samartzidis/NanoBot/models/head-bottom.stl

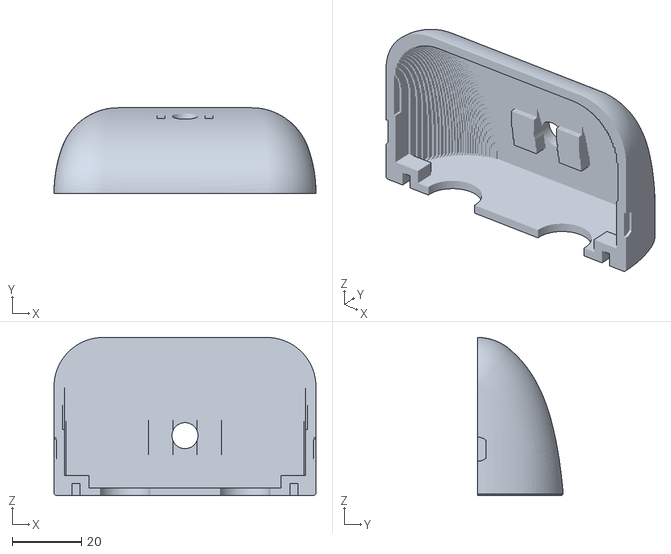
[picture p10: CAD file, 2026-02-01]
models/head-bottom.stl
75.6 x 24.7 x 45.6
