samartzidis/NanoBot/models/face.stl

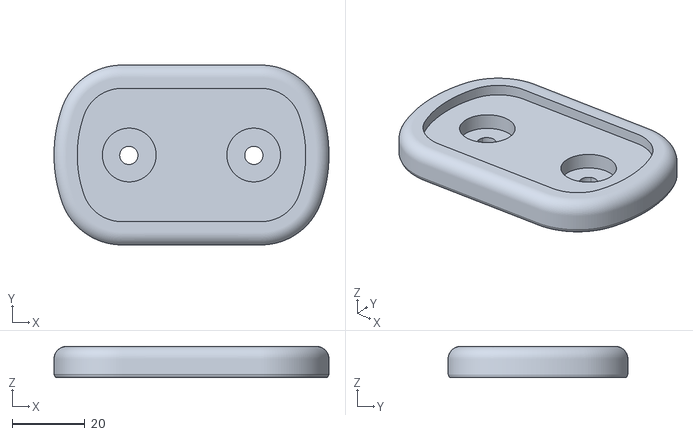
[picture p11: CAD file, 2026-02-01]
models/face.stl
75.6 x 49.4 x 8.61
