samartzidis/NanoBot/models/head-top.stl

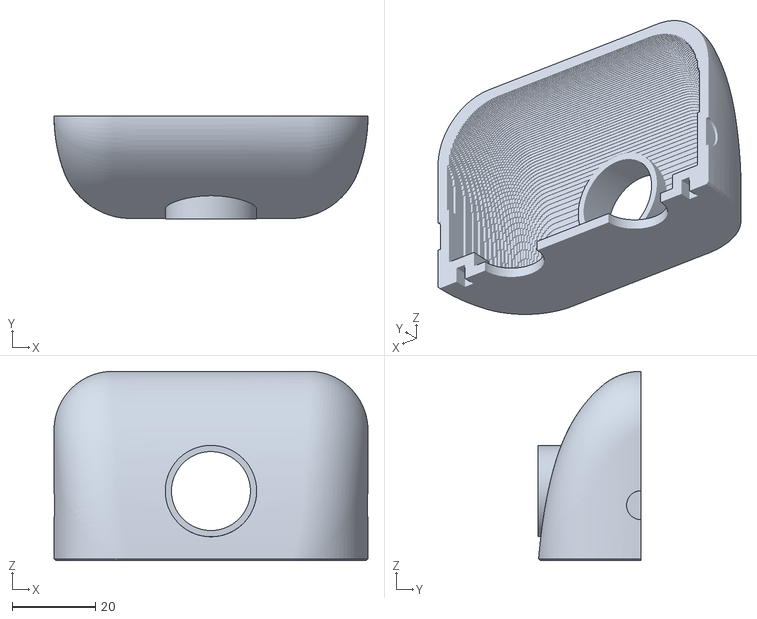
[picture p12: CAD file, 2026-02-01]
models/head-top.stl
75.6 x 24.8 x 45.6
