samartzidis/NanoBot/models/body.stl

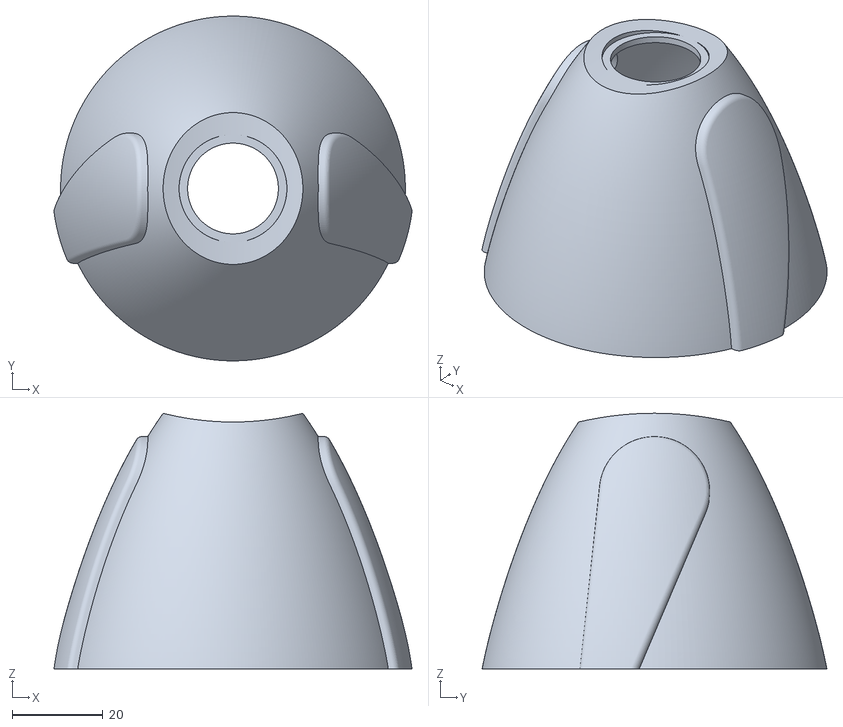
[picture p13: CAD file, 2026-02-01]
models/body.stl
79.0 x 76.0 x 56.4
