samartzidis/NanoBot/models/eyes.stl

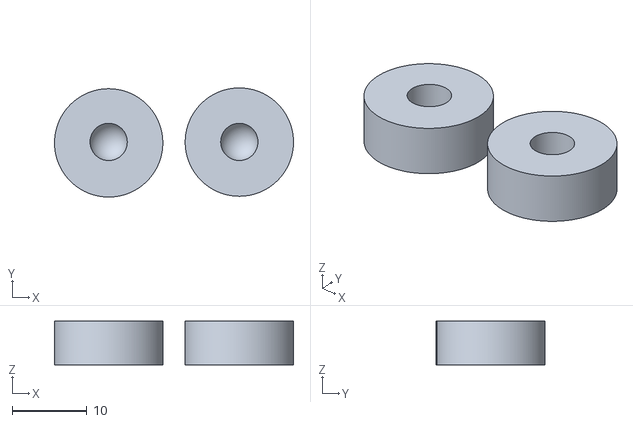
[picture p14: CAD file, 2026-02-01]
models/eyes.stl
32.1 x 14.6 x 5.88
