samartzidis/NanoBot/models/ears.stl

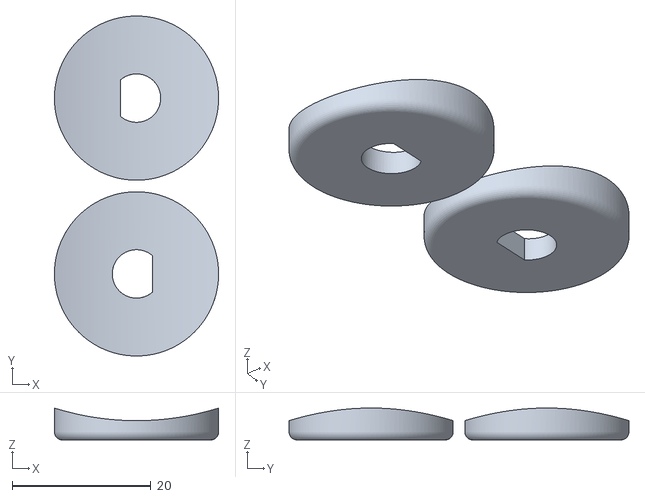
[picture p16: CAD file, 2026-02-01]
models/ears.stl
23.7 x 49.0 x 4.61
