samartzidis/NanoBot/models/antennas.stl

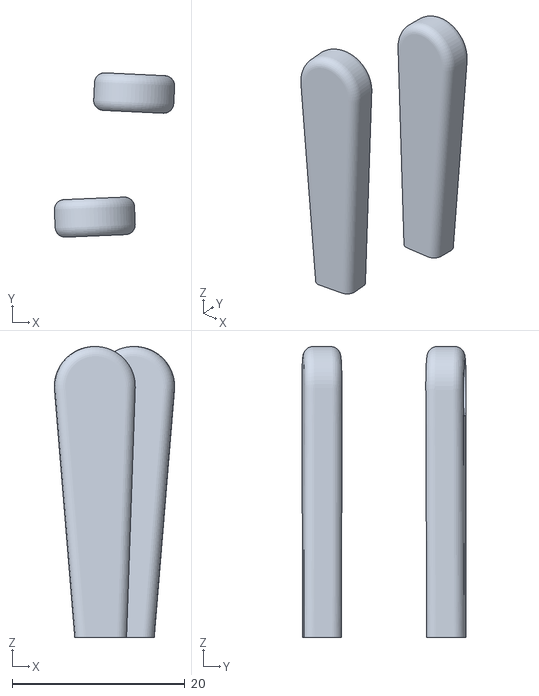
[picture p17: CAD file, 2026-02-01]
models/antennas.stl
13.9 x 19.1 x 33.7
