samartzidis/NanoBot/models/base.stl

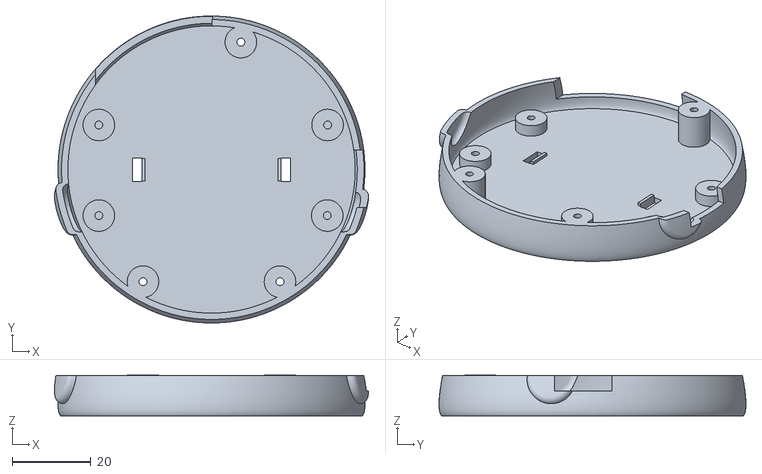
[picture p18: CAD file, 2026-02-01]
models/base.stl
79.7 x 77.9 x 10.3
