samartzidis/NanoBot/models/neck.stl

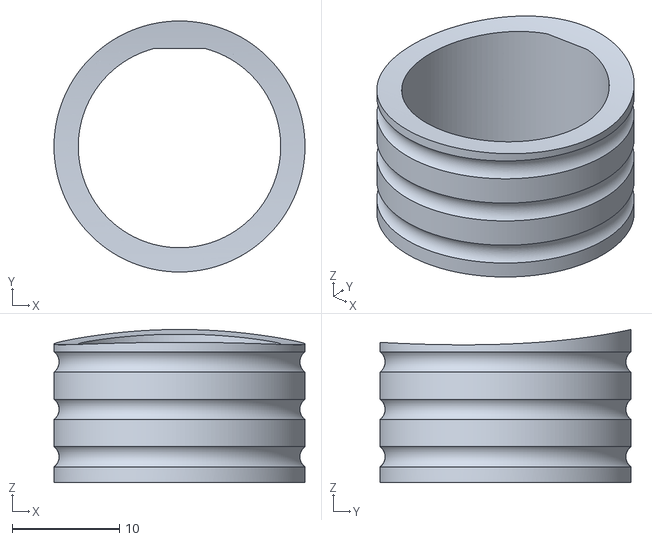
[picture p19: CAD file, 2026-02-01]
models/neck.stl
23.4 x 23.4 x 14.3
