samartzidis/NanoBot/models/S330-attachment-draft.3mf

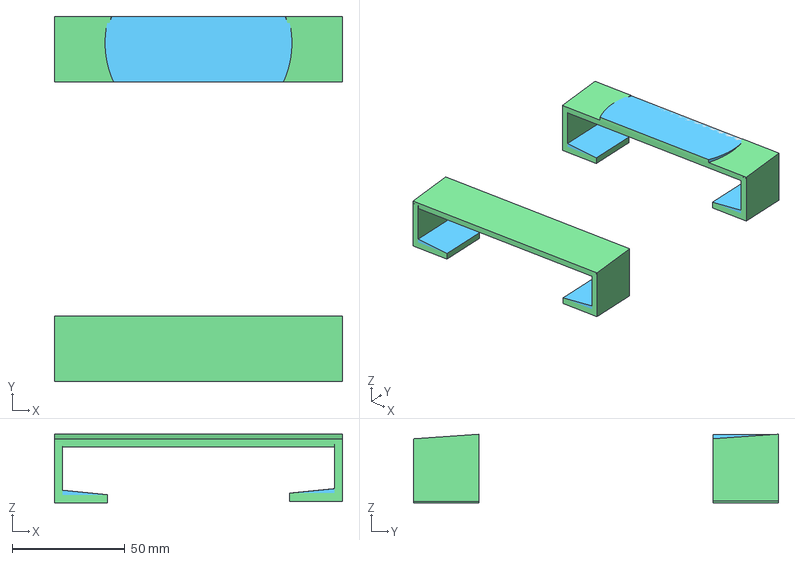
[picture p20: CAD file, 2025-01-10]
models/S330-attachment-draft.3mf
128.0 x 162.1 x 30.5 mm
