samartzidis/NanoBot/(commit log)

2025-11-06 Assign GPIO19 pin to optional speaker amplifier control
2025-11-10 Commented out Anker PowerConf S330 Driver code
2025-11-16 Extra led colours for noise,voice detection indication using PWM pins
2026-01-03 Restored PowerConfDeviceService
2026-02-01 Added printable STL files
    [antennas.stl, base.stl, body.stl, ear-bits.stl, ears.stl, eyes.stl, face.stl, head-bottom.stl]
2026-02-01 model updates
    [face.stl, head-bottom.stl, head-top.stl]
2026-02-01 models update
    [S330-attachment-draft.3mf, s330-speakerphone-attachment.stl]
2026-04-11 forwarding of tools to the powerai plugin
2026-04-12 PowerAIPlugin selection instructions moved to config
2026-04-25 Added filtering to logs UI page, improved error handling in RealtimeAgent
2026-05-09 Fix WebSocket disconnect logging and cancellation propagation
    When the OpenAI Realtime API closes the connection abruptly (no close
    handshake), the receive task now catches WebSocketException immediately,
    logs at Warning, and calls FaultSession() before rethrowing. Previously
    the exception silently faulted the task without calling FaultSession(),
    leaving the audio loop running until it hit the aborted socket itself and
    produced a misleading [Error] stack trace as a secondary symptom.
    Knock-on effects:
    - FaultSession() cancels _sessionCts promptly, so the audio loop receives
    OperationCanceledException via loopCts instead of WebSocketException
    - SystemService now has a dedicated catch (WebS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
2026-09-12 Simplify PowerAIPlugin to a single-shot completion
    The realtime agent already has direct access to the same tools and is
    instructed per-plugin to gather facts itself before escalating, making
    PowerAIPlugin's own tool-calling loop redundant. Removes the tools
    dependency, iteration loop, and InvokeToolAsync/BuildOptions tool wiring.
2026-09-12 Updated powerai prompt
2026-09-12 Introduce shared AudioOutputEngine for audio playback
    Speaker previously opened its own private MiniAudioEngine/AudioPlaybackDevice
    per instance, so two Speakers could contend for exclusive access to the same
    physical output. AudioOutputEngine (Services/) now owns the single output
    device as a DI singleton; Speaker requires it and only manages its own
    SoundPlayer/QueueDataProvider/level-meter on the engine's shared mixer, so
    multiple Speakers can mix in hardware instead. RealtimeAgent/RealtimeAgentFactory
    wire it through via constructor injection.
2026-10-03 Add Firecrawl-backed WebSearchPlugin
    Add an opt-in web search plugin using the Firecrawl v2 API.
    - SearchAsync: returns title/url/description only (cheap, no page
    content), with optional past-day and site filters
    - ReadPageAsync: answers a specific question from a page via the
    "question" format, falling back to truncated main-content markdown
    - Failures, empty results and empty pages return an explicit
    instruction telling the model not to guess
    - Add WebSearchPluginEnabled (per agent) and FirecrawlApiKey (app)
    config, UI schema entries and factory registration
    - Plugin instructions require user permission before searching and
    forbid presenting guesses or memory as web results
2026-10-11 Add picture upload into the realtime conversation
    Let users send a photo from the web UI (including the phone camera) so
    they can ask the robot about it by voice.
    - Add POST api/Conversation/Image (jpeg/png/webp/gif, 4 MB cap)
    - RealtimeAgent.AddImageAsync adds the image as a user input_image item
    without triggering a response; images are queued (max 3) when there is
    no live session and flushed after the session is configured
    - SystemService forwards images to the current agent, holds them until an
    agent exists, and says "Picture received" via local TTS
    - Set image_url through the part's JsonPatch because System.Uri rejects
    strings over ~65K chars on .NET 8, shorter than a base64 ph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
2026-10-11 Wake the agent into listening mode after an image upload
    When the system is idle waiting for a wake word, an uploaded image now
    wakes the agent the same way the hangup button does, so the user can ask
    about the picture straight away. The wake happens after the "Picture
    received" announcement so the microphone doesn't capture it. A live
    conversation is left untouched; the image goes straight into the session.
2026-10-12 Upload ui button move
2026-10-16 Let PowerAI see uploaded images via a labelled in-memory store
    Uploaded images are now kept in an in-memory IUploadedImageStore (max 5,
    drop oldest) and given short labels (img-1, img-2, ...). The realtime
    model is told each label via a text part sent with the image, and
    PowerAIPlugin.AskAsync gains an optional imageIds parameter that
    attaches the referenced images to the PowerAI request.
    - Add UploadedImageStore; the label counter never resets so a stale
    label can't alias a newer image
    - PendingImageQueue now carries StoredImage records (label + bytes + mime)
    - SystemService stores each upload first and clears the store on agent
    disposal, keeping images still queued for the next sessio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
2026-10-17 Remove GeoIP and Weather plugins
    Delete GeoIpPlugin and WeatherPlugin along with their AgentConfig
    flags, RealtimeAgentFactory wiring and agent UI schema controls.
    Drop the README mention and change the PowerAI instruction example
    from "date/time, weather, location" to "date/time, web search".
2026-10-25 Add system status page with Windows support
    - Split SystemInfoPlugin's readers into SystemInfoService, returning a
    structured SystemStatus; the plugin now only formats it into spoken
    sentences for the voice agent.
    - Add GET api/System/GetStatus, returning the status as JSON.
    - Add Windows support: memory and uptime via GlobalMemoryStatusEx/
    TickCount64 (Util/WindowsMemory.cs), Wi-Fi SSID/RSSI via wlanapi.dll
    (Util/WindowsWifi.cs), disk via the system drive. CPU temperature
    stays Raspberry Pi-only.
    - Register SystemInfoPlugin for the voice agent on Windows as well as
    Linux.
    - Add a Home page status card grid (SystemStatusCards.tsx): Wi-Fi,
    memory, CPU temperature, uptime, disk;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
2026-10-26 Add history graphs to system status page
    Show Wi-Fi signal (dBm), memory used (%) and, on a Raspberry Pi, CPU
    temperature (°C) as line charts under the status cards, using
    @mui/x-charts.
    History is collected in the browser from the existing 5 s status poll
    and keeps the last hour, so it starts empty on page load. Each graph
    appears with the first sample. The y-axes have fixed ranges because
    auto-scaling a flat line produced degenerate tick labels.
    @mui/x-charts is pinned to ^7.29.1: later releases require MUI 7+, and
    the project is on MUI 6.
2026-10-26 Add Orange Pi Zero 2W support and multi-zone temperature graph
2026-10-26 Remove Captive Portal Device installation instructions
    Removed optional installation instructions for Captive Portal Device software from the README.
2026-10-29 Detect dropped realtime sessions on wake-up, add LED Blink, build UI on publish
    Realtime session reliability:
    - Check a kept-alive session when a conversation starts: if the server
    has been silent for 30 s, re-send the session config and wait up to 2 s
    for session.updated. A dead or silent connection is reset and a fresh
    session is created, instead of failing mid-conversation with
    "WebSocket closed without completing the close handshake".
    - Make SessionTimeoutMinutes an idle timeout (time since the last
    conversation ended) as its description says, rather than time since
    creation. Add a 50 minute maximum session age so a continuously used
    session is recycled before OpenAI's 60 m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
2026-10-29 Switch the Power AI model choices to the GPT-6 family (gpt-6-astra, gpt-6.1-sol, gpt-6.1-terra, gpt-6-luna) and make gpt-6-luna the default.
2026-10-30 Fix Speaker.FlushAsync waiting forever after Stop()
    Stopping the speaker halts playback without draining its queue, so a
    flush started by the realtime receive loop's ResponseDone handler never
    finished when a conversation was hung up mid-speech. The receive loop
    then stopped reading the socket, the wake-time session check timed out,
    and the connection was dropped because server pings went unanswered.
    FlushAsync now returns as soon as the speaker is stopped or disposed.
2026-10-30 Read the realtime socket in its own task so handlers can't stall it
    Read the websocket in a separate task and hand updates to the handler
    loop through a channel. Handlers that wait for playback or for a tool no
    longer stop the socket being read, so server pings and the wake-time
    session check's session.updated reply are handled promptly instead of
    the connection being dropped.
2026-10-30 Don't dispose the realtime agent under a running conversation on config change
    Saving the configuration mid-conversation disposed the agent from the
    web request thread while the audio capture loop was still using its VAD
    model, causing a NullReferenceException, red eyes and a spoken error.
    During a run the config change now ends the conversation via the hangup
    token and the main loop rebuilds the agent once the run has finished;
    when idle the agent is still disposed immediately.
2026-10-31 Document full Armbian setup for Orange Pi Zero 2W
    Rewrite the Orange Pi Zero 2W platform preparation in the README so
    it is complete and self-contained for the two supported Armbian
    images (Ubuntu 26.04 and Debian 13, Minimal CLI), including the
    default root login. PWM overlays are now configured in
    armbianEnv.txt, and the gpio group creation, WiFi power saving, mic
    sharing check, .NET 8 SDK install and an optional port 80 setting
    are now covered.
2026-11-01 Require stronger speech to barge in; re-ask on false ones
    A false barge-in, most likely the speaker's own echo, cut off an answer
    after "Nice try!". The recording that followed held only two frames of
    speech and was discarded, so nothing asked for the answer again and the
    session went idle.
    Interrupting the model now needs a triggering frame of at least 0.85,
    instead of the 0.7 used for starting a normal recording. In the logs the
    echo peaked at 0.70-0.80 and real interruptions reached 0.90 or more.
    That is only seven samples, so the value is a starting point.
    A barge-in that cancelled or truncated an answer now marks the
    recording, so if it is discarded as near-empty the answer is request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
